Telfair8632/sr71-600/docs/cutting_templates_1to1.pdf

F02_Elevon_L | FOAM 3mm | QTY 1
Row 1/1 Col 1/1 | Origin (495.0,125.0) | Print at 100%; do not fit to page

Horizontal check 100 mm

Grid cross spacing 50 mm; adjacent pages overlap 10 mm; blue lines = score/locate, black lines = cut through.

F02_Elevon_R | FOAM 3mm | QTY 1
Row 1/1 Col 1/1 | Origin (495.0,-207.9) | Print at 100%; do not fit to page

F01_Wing_chine_NET | FOAM 3mm | QTY 1
Row 1/2 Col 1/4 | Origin (0.0,-210.0) | Print at 100%; do not fit to page

F01_Wing_chine_NET | FOAM 3mm | QTY 1
Row 1/2 Col 2/4 | Origin (180.0,-210.0) | Print at 100%; do not fit to page

F01_Wing_chine_NET | FOAM 3mm | QTY 1
Row 1/2 Col 3/4 | Origin (360.0,-210.0) | Print at 100%; do not fit to page

F01_Wing_chine_NET | FOAM 3mm | QTY 1
Row 1/2 Col 4/4 | Origin (540.0,-210.0) | Print at 100%; do not fit to page

F01_Wing_chine_NET | FOAM 3mm | QTY 1
Row 2/2 Col 1/4 | Origin (0.0,25.0) | Print at 100%; do not fit to page

F01_Wing_chine_NET | FOAM 3mm | QTY 1
Row 2/2 Col 2/4 | Origin (180.0,25.0) | Print at 100%; do not fit to page

F01_Wing_chine_NET | FOAM 3mm | QTY 1
Row 2/2 Col 3/4 | Origin (360.0,25.0) | Print at 100%; do not fit to page

F01_Wing_chine_NET | FOAM 3mm | QTY 1
Row 2/2 Col 4/4 | Origin (540.0,25.0) | Print at 100%; do not fit to page

F03_Fuselage_side | FOAM 3mm | QTY 2
Row 1/1 Col 1/3 | Origin (70.0,3.0) | Print at 100%; do not fit to page

F03_Fuselage_side | FOAM 3mm | QTY 2
Row 1/1 Col 2/3 | Origin (250.0,3.0) | Print at 100%; do not fit to page

F03_Fuselage_side | FOAM 3mm | QTY 2
Row 1/1 Col 3/3 | Origin (430.0,3.0) | Print at 100%; do not fit to page

F04_Roof_frame | FOAM 3mm | QTY 1
Row 1/1 Col 1/3 | Origin (70.0,-22.0) | Print at 100%; do not fit to page

F04_Roof_frame | FOAM 3mm | QTY 1
Row 1/1 Col 2/3 | Origin (250.0,-22.0) | Print at 100%; do not fit to page

F04_Roof_frame | FOAM 3mm | QTY 1
Row 1/1 Col 3/3 | Origin (430.0,-22.0) | Print at 100%; do not fit to page

F05_Battery_hatch | FOAM 3mm | QTY 1
Row 1/1 Col 1/2 | Origin (0.0,0.0) | Print at 100%; do not fit to page

F05_Battery_hatch | FOAM 3mm | QTY 1
Row 1/1 Col 2/2 | Origin (180.0,0.0) | Print at 100%; do not fit to page

F05_Avionics_hatch | FOAM 3mm | QTY 1
Row 1/1 Col 1/1 | Origin (0.0,0.0) | Print at 100%; do not fit to page

W01_Battery_tray | PLY 1mm | QTY 1
Row 1/1 Col 1/1 | Origin (95.0,-17.0) | Print at 100%; do not fit to page

W02_Bulkhead | PLY 1mm | QTY 3
Row 1/1 Col 1/1 | Origin (0.0,0.0) | Print at 100%; do not fit to page

F06_Nacelle_wrap | FOAM 2mm | QTY 2
Row 1/1 Col 1/2 | Origin (0.0,0.0) | Print at 100%; do not fit to page

F06_Nacelle_wrap | FOAM 2mm | QTY 2
Row 1/1 Col 2/2 | Origin (180.0,0.0) | Print at 100%; do not fit to page

F07_Vertical_fin | FOAM 3mm | QTY 2
Row 1/1 Col 1/1 | Origin (420.0,42.0) | Print at 100%; do not fit to page

F08_Belly_skid | FOAM 3mm | QTY 4
Row 1/1 Col 1/1 | Origin (510.0,-14.0) | Print at 100%; do not fit to page

F09_Spike_web | FOAM 2mm | QTY 2
Row 1/1 Col 1/1 | Origin (0.0,0.0) | Print at 100%; do not fit to page

W03_Motor_firewall | PLY 1mm | QTY 4
Row 1/1 Col 1/1 | Origin (-18.0,-18.0) | Print at 100%; do not fit to page

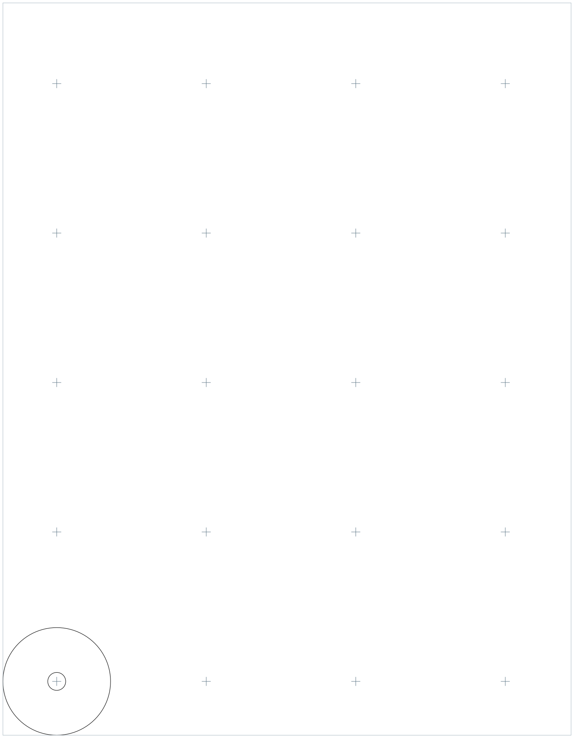
[picture p3: figure]

W04_Nacelle_former_BLANK | PLY 1mm | QTY 6
Row 1/1 Col 1/1 | Origin (-18.0,-18.0) | Print at 100%; do not fit to page

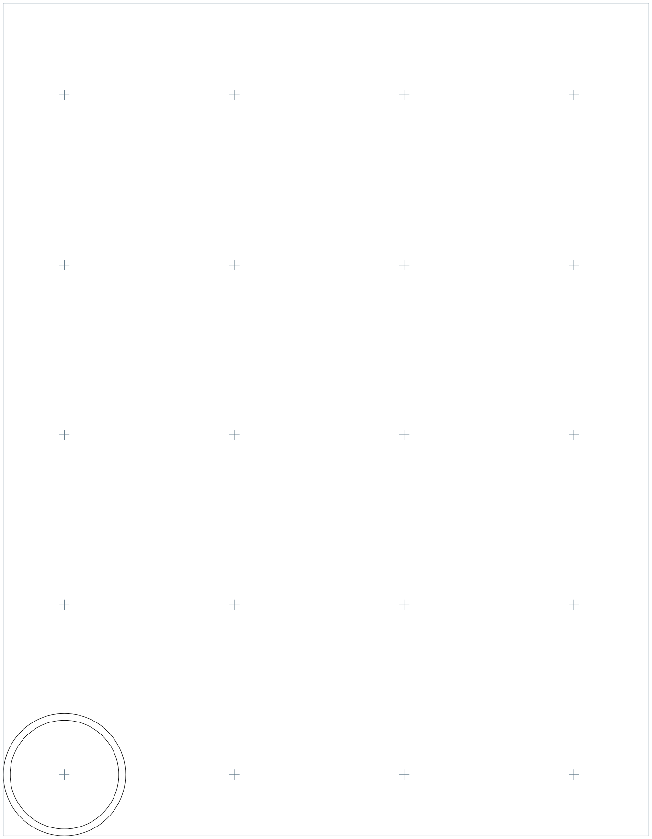
[picture p4: figure]
