Telfair8632/sr71-600/docs/cutaway.png

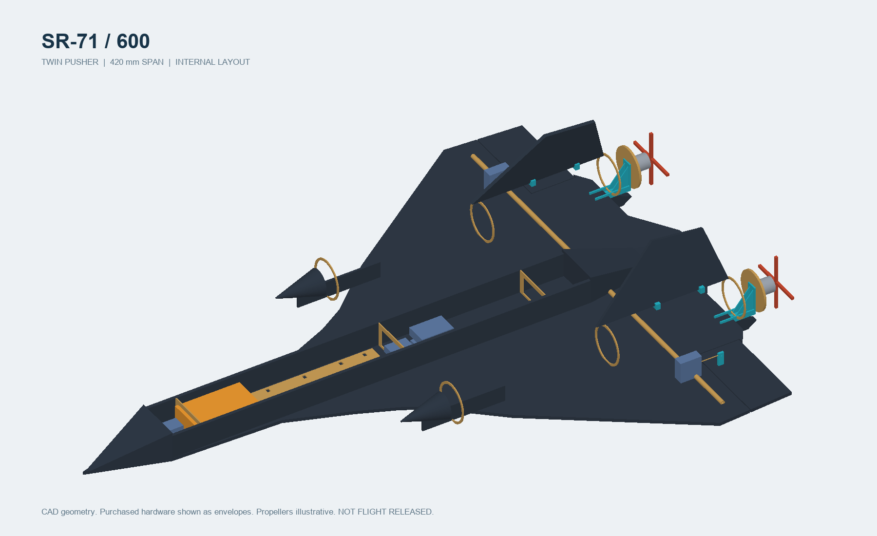
docs/cutaway.png
