Telfair8632/sr71-600/qa/pdf_render/circuit_design_E1_04.png

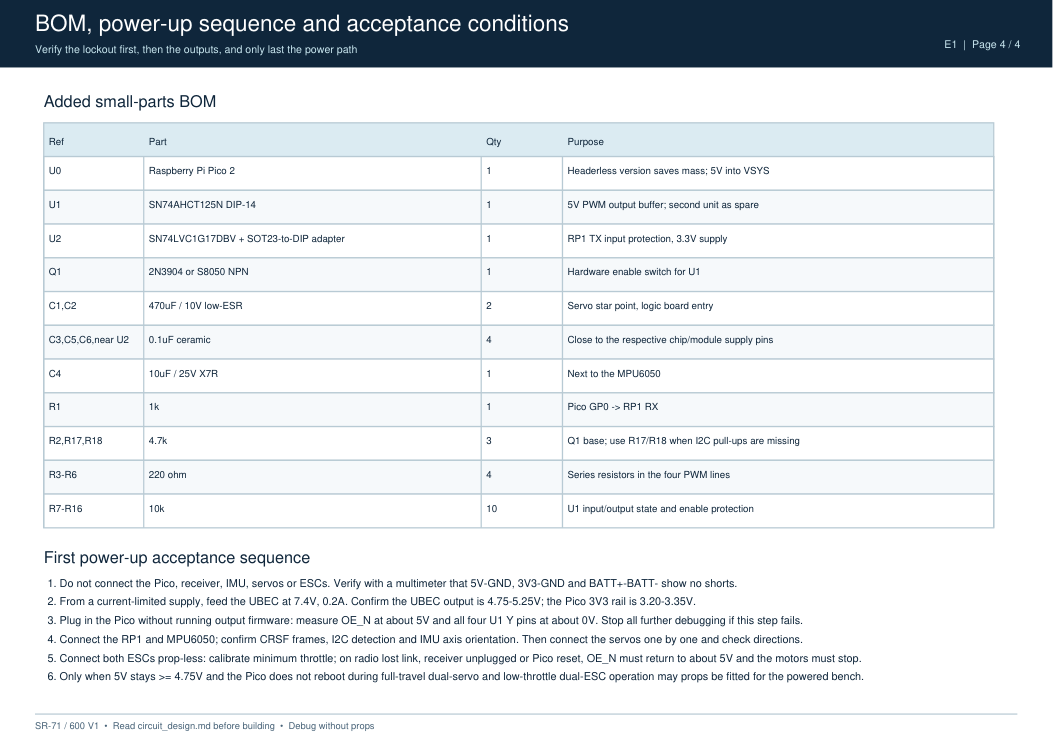
qa/pdf_render/circuit_design_E1_04.png
