Telfair8632/sr71-600/qa/pdf_render/engineering_report_09.png

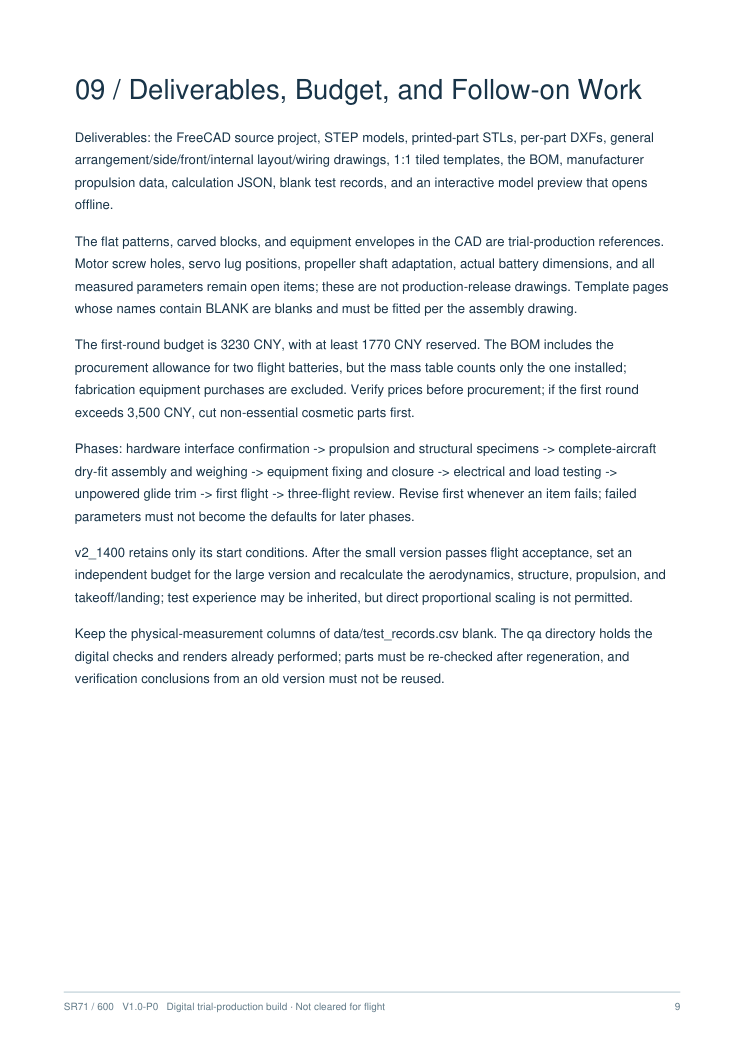
qa/pdf_render/engineering_report_09.png
