Telfair8632/sr71-600/qa/pdf_render/engineering_report_10.png

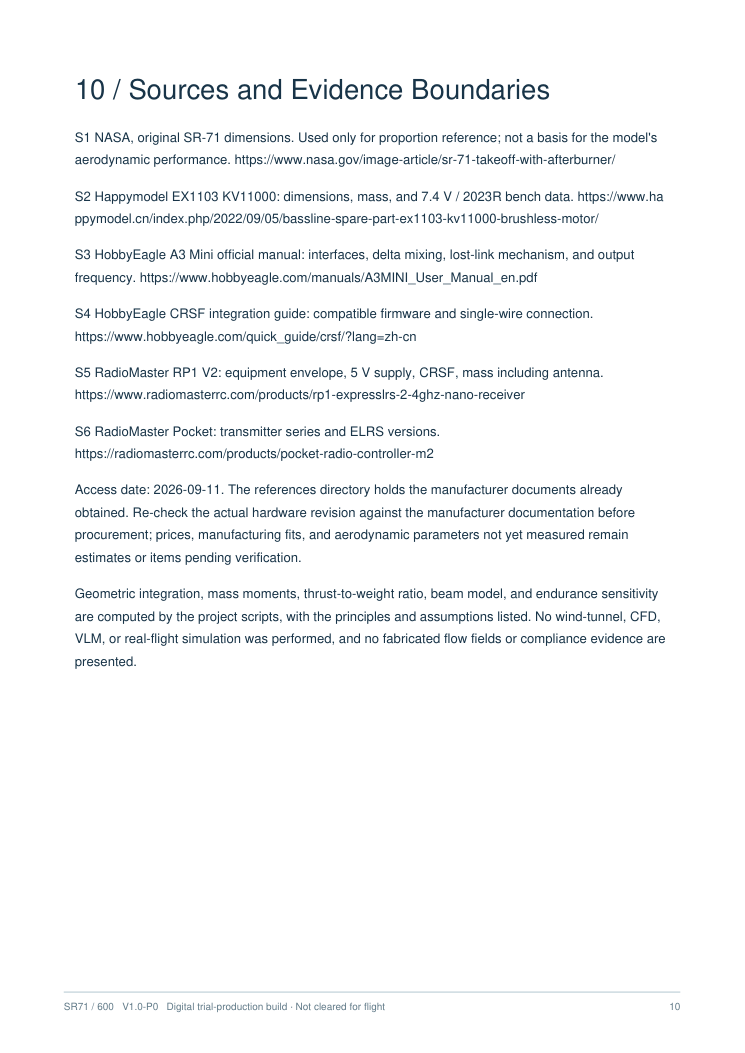
qa/pdf_render/engineering_report_10.png
