Telfair8632/sr71-600/qa/pdf_render/engineering_report_contact_1.png

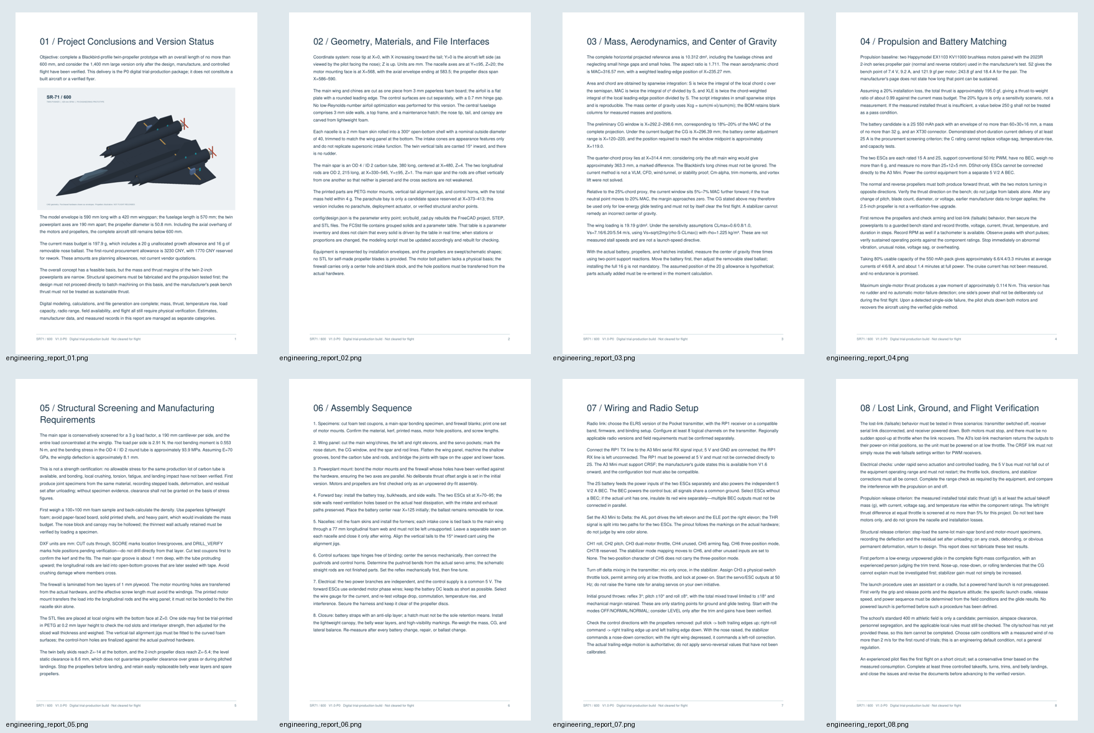
qa/pdf_render/engineering_report_contact_1.png
