Telfair8632/sr71-600/qa/viewer_overview.png

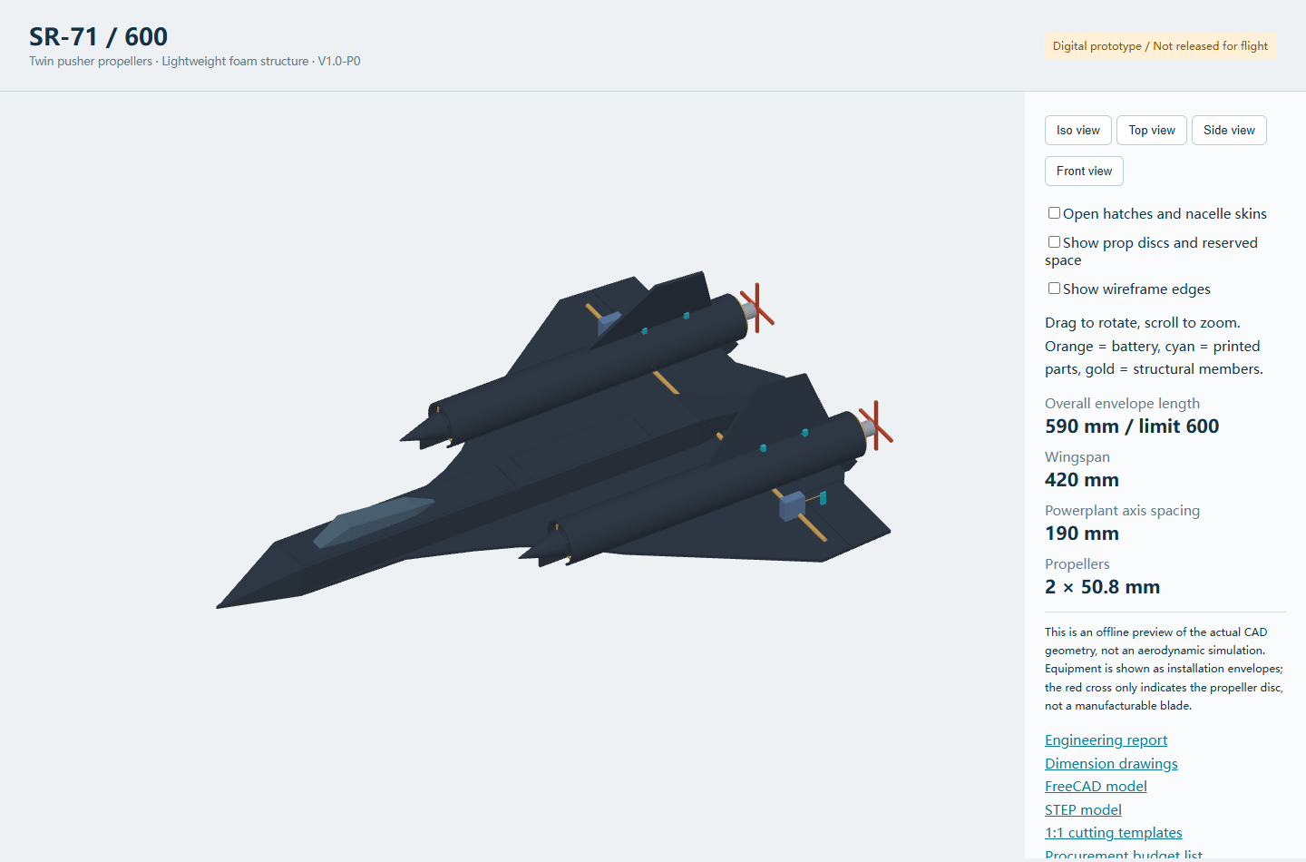
qa/viewer_overview.png
