Telfair8632/sr71-600/cad/SR71_600_P0.step

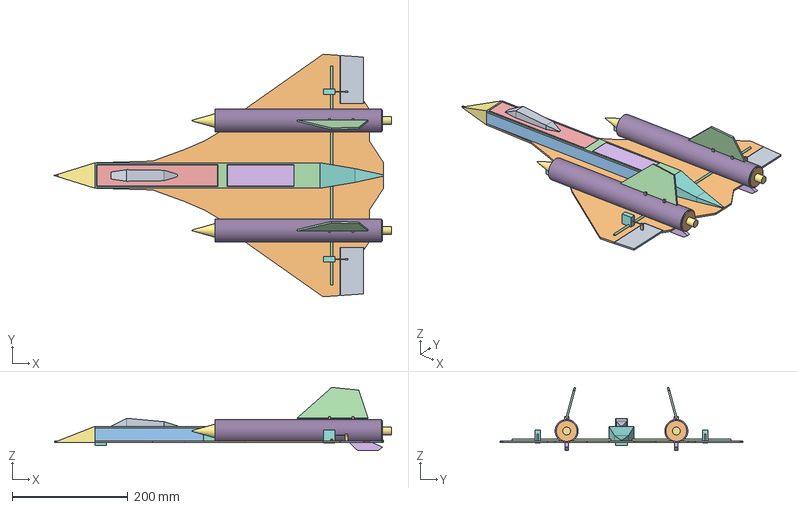
[picture p23: CAD file, 2026-10-15]
cad/SR71_600_P0.step
583.5 x 420.0 x 109.5 mm
左升降副翼（左后缘舵面）
右升降副翼（右后缘舵面）
主翼与边条整体板
中央机身左侧壁
中央机身右侧壁
中央机身顶框
前部电池舱盖
后部航电舱盖
机头泡沫整形块
机尾泡沫整形块
座舱泡沫外形件
电池托板
前隔框（X=98）
中隔框（X=287）
后隔框（X=419）
横向碳管主梁
左机舱纵向碳杆
左发动机舱泡沫外壳
左进气锥外形件
左进气锥支撑腹板
左机舱前成形圈（X=285）
左机舱中成形圈（X=430）
左机舱后成形圈（X=548）
左电机防火墙毛坯
左电机托
左垂尾
左垂尾前托（X=474）
左垂尾后托（X=515）
左机腹耐磨滑橇
左无刷电机安装包络
左升降副翼舵机安装包络
左升降副翼拉杆
左升降副翼舵角
右机舱纵向碳杆
右发动机舱泡沫外壳
右进气锥外形件
右进气锥支撑腹板
右机舱前成形圈（X=285）
右机舱中成形圈（X=430）
右机舱后成形圈（X=548）
右电机防火墙毛坯
右电机托
右垂尾
右垂尾前托（X=474）
右垂尾后托（X=515）
右机腹耐磨滑橇
右无刷电机安装包络
右升降副翼舵机安装包络
右升降副翼拉杆
右升降副翼舵角
2S电池安装包络
左电调安装包络
右电调安装包络
独立BEC安装包络
ELRS接收机安装包络
三角翼稳定器安装包络
可拆机头配重安装包络
