Telfair8632/sr71-600/cut/F06_Nacelle_wrap.dxf

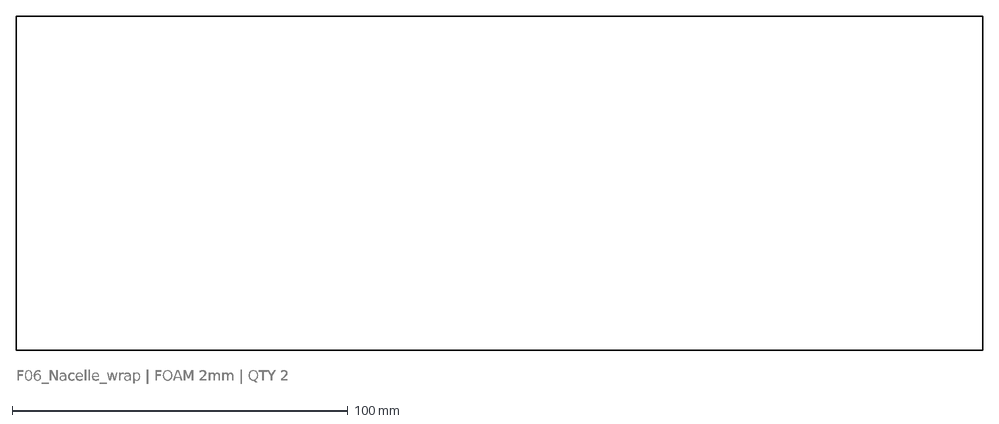
[picture p24: CAD file, 2026-10-15]
cut/F06_Nacelle_wrap.dxf
F06_Nacelle_wrap | FOAM 2mm | QTY 2
