Telfair8632/sr71-600/print/Fin_saddle_L_474.stl

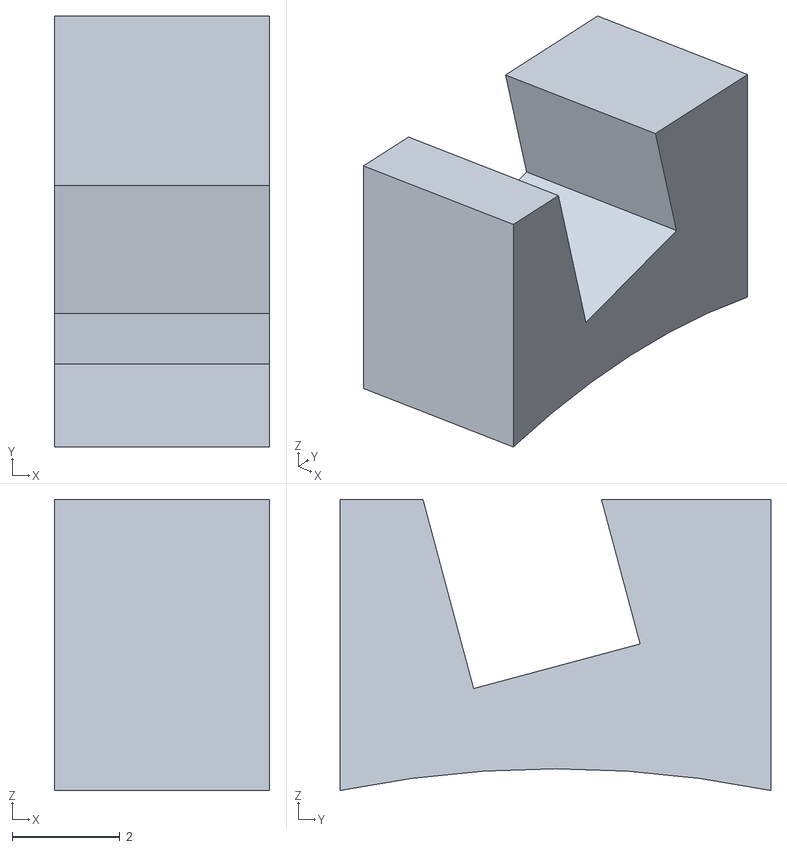
[picture p25: CAD file, 2026-10-15]
print/Fin_saddle_L_474.stl
4.00 x 8.00 x 5.40
