Telfair8632/sr71-600/cut/F01_Wing_chine_NET.dxf

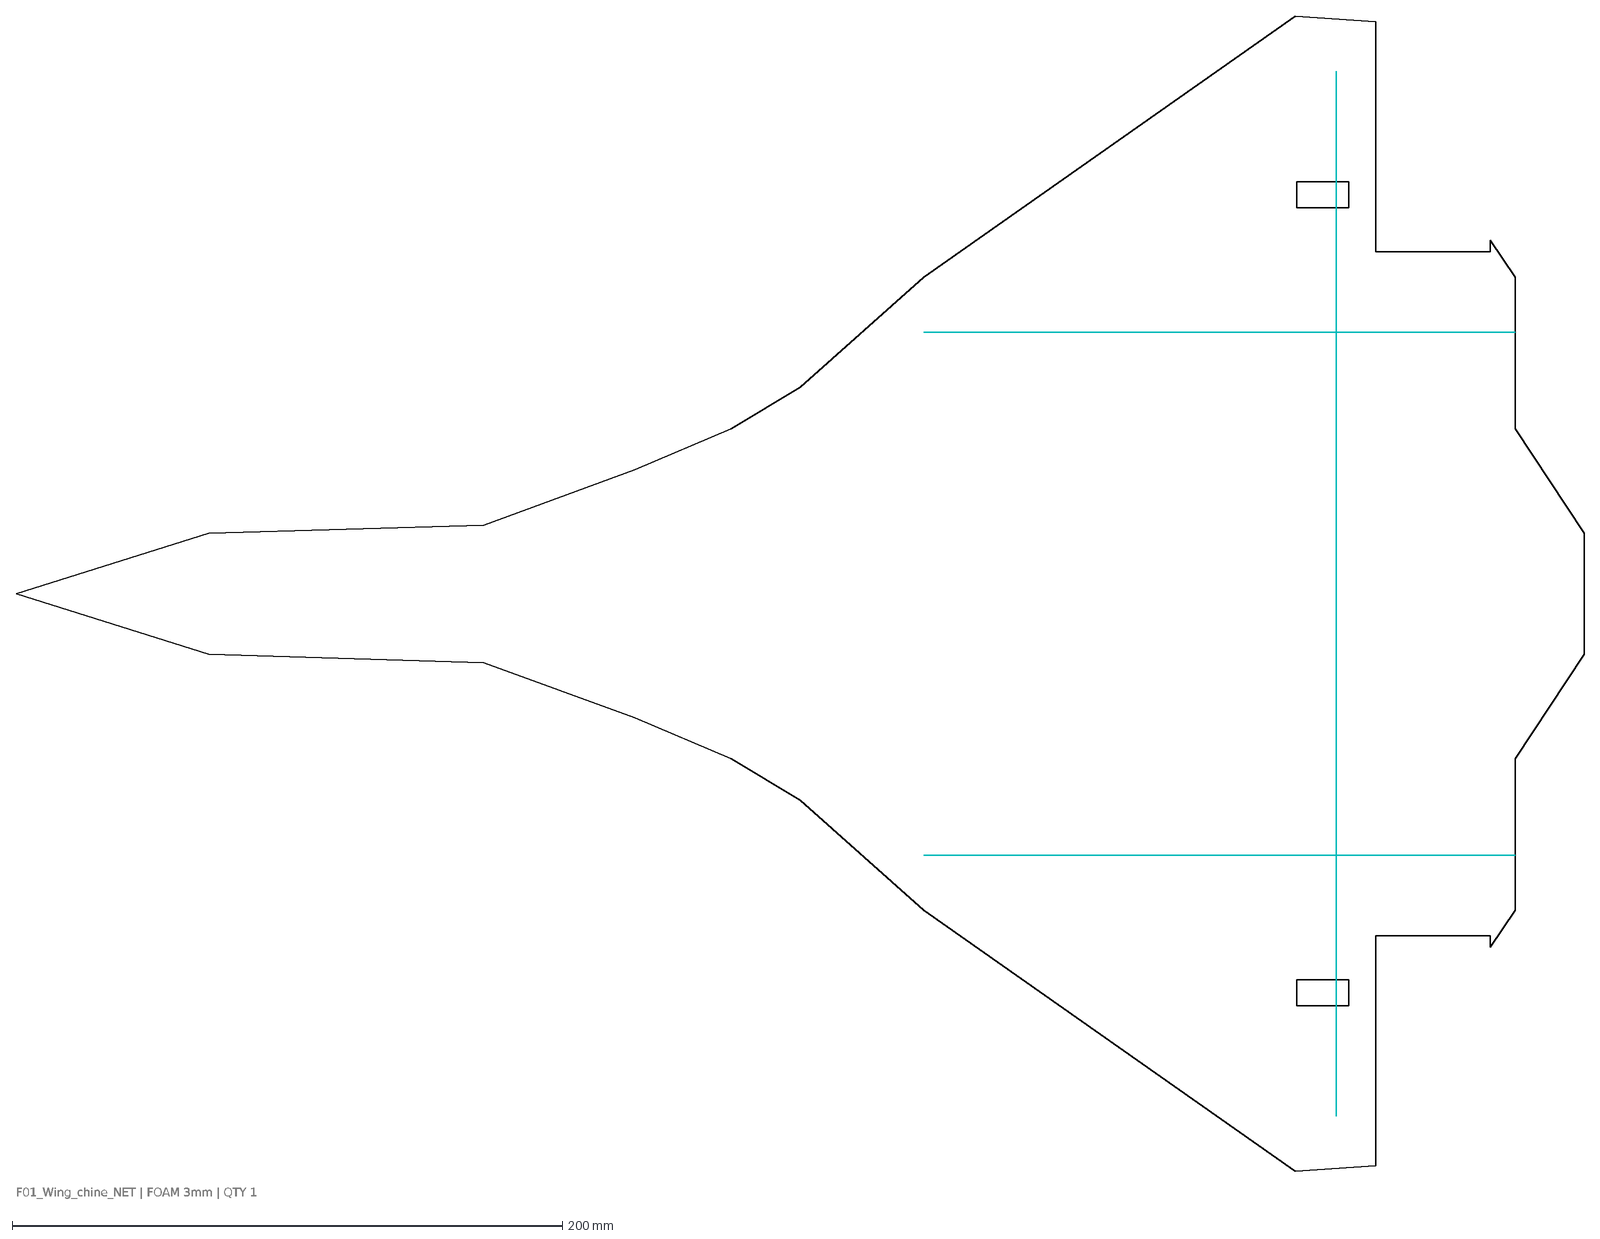
[picture p26: CAD file, 2026-10-15]
cut/F01_Wing_chine_NET.dxf
F01_Wing_chine_NET | FOAM 3mm | QTY 1
