Telfair8632/sr71-600/cut/F02_Elevon_R.dxf

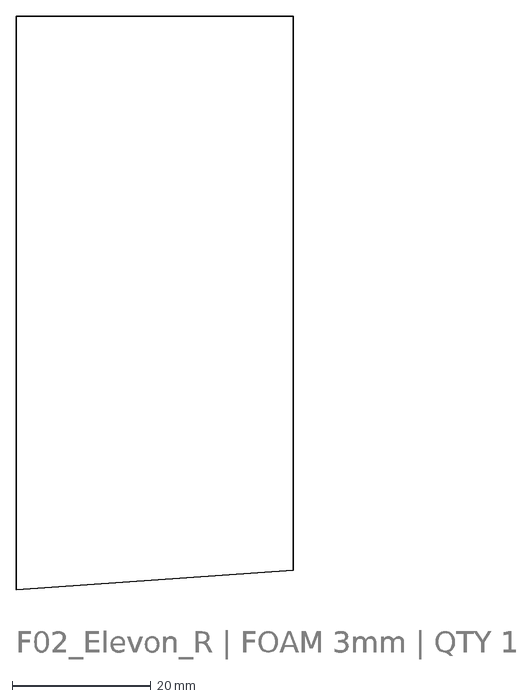
[picture p27: CAD file, 2026-10-15]
cut/F02_Elevon_R.dxf
F02_Elevon_R | FOAM 3mm | QTY 1
