Telfair8632/sr71-600/print/Control_horn_R.stl

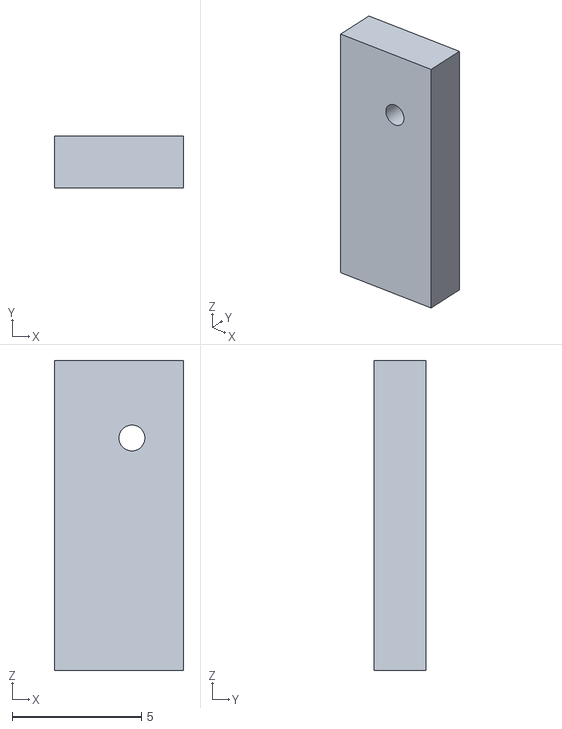
[picture p28: CAD file, 2026-10-15]
print/Control_horn_R.stl
5.00 x 2.00 x 12.0
