Telfair8632/sr71-600/cut/F05_Battery_hatch.dxf

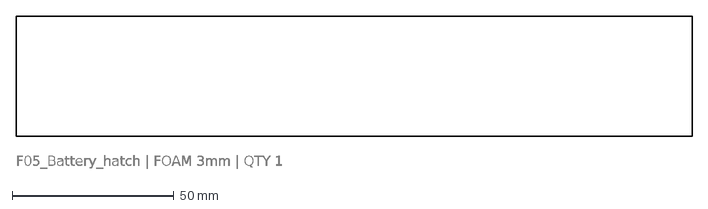
[picture p29: CAD file, 2026-10-15]
cut/F05_Battery_hatch.dxf
F05_Battery_hatch | FOAM 3mm | QTY 1
