Telfair8632/sr71-600/cut/F03_Fuselage_side.dxf

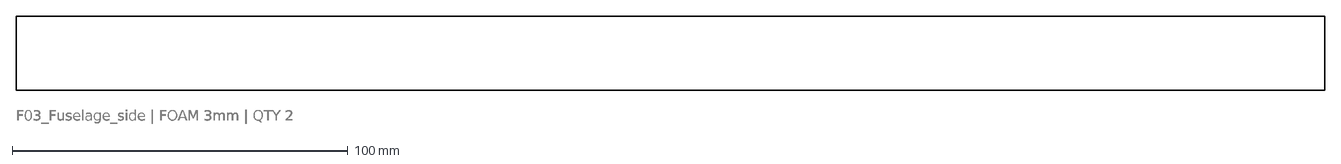
[picture p30: CAD file, 2026-10-15]
cut/F03_Fuselage_side.dxf
F03_Fuselage_side | FOAM 3mm | QTY 2
