Telfair8632/sr71-600/print/Motor_saddle_L.stl

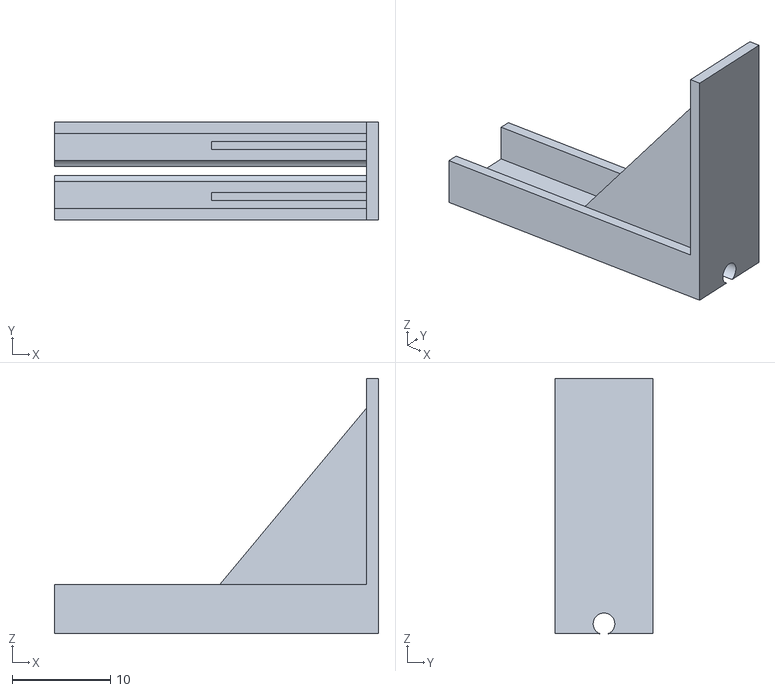
[picture p31: CAD file, 2026-10-15]
print/Motor_saddle_L.stl
33.0 x 10.0 x 26.0
