Telfair8632/sr71-600/cut/F08_Belly_skid.dxf

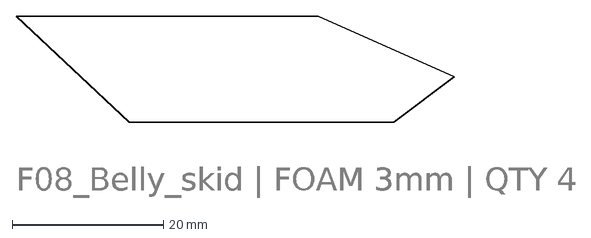
[picture p32: CAD file, 2026-10-15]
cut/F08_Belly_skid.dxf
F08_Belly_skid | FOAM 3mm | QTY 4
