Telfair8632/sr71-600/cut/F02_Elevon_L.dxf

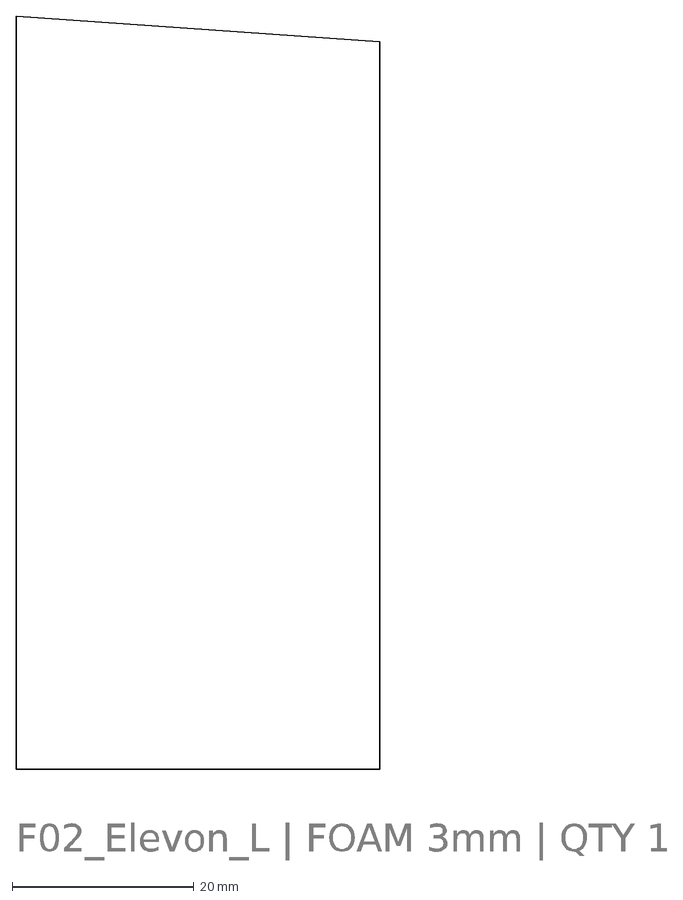
[picture p33: CAD file, 2026-10-15]
cut/F02_Elevon_L.dxf
F02_Elevon_L | FOAM 3mm | QTY 1
