Telfair8632/sr71-600/cut/F07_Vertical_fin.dxf

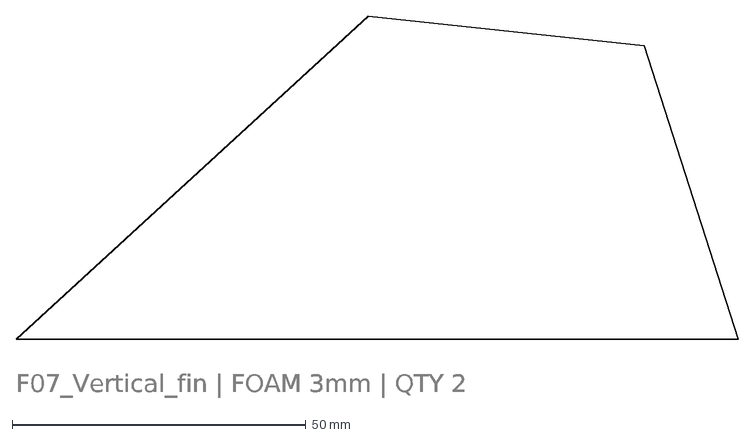
[picture p34: CAD file, 2026-10-15]
cut/F07_Vertical_fin.dxf
F07_Vertical_fin | FOAM 3mm | QTY 2
