Telfair8632/sr71-600/cut/W04_Nacelle_former_BLANK.dxf

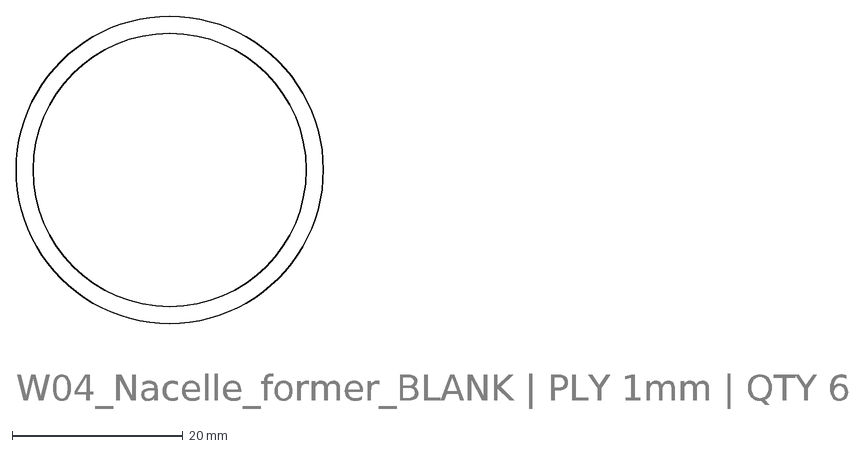
[picture p35: CAD file, 2026-10-15]
cut/W04_Nacelle_former_BLANK.dxf
W04_Nacelle_former_BLANK | PLY 1mm | QTY 6
