Telfair8632/sr71-600/cut/W02_Bulkhead.dxf

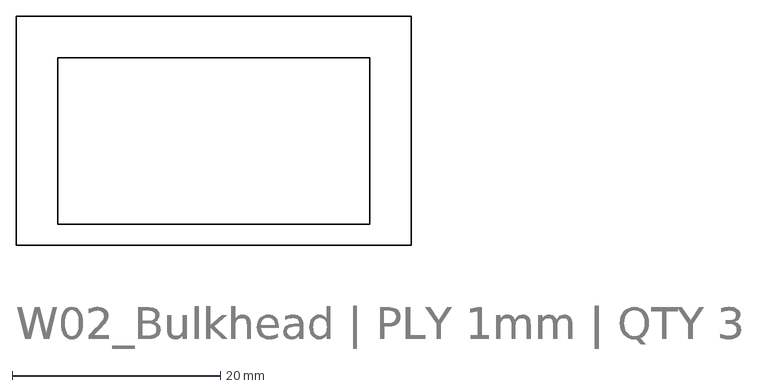
[picture p36: CAD file, 2026-10-15]
cut/W02_Bulkhead.dxf
W02_Bulkhead | PLY 1mm | QTY 3
