Telfair8632/sr71-600/cut/W03_Motor_firewall.dxf

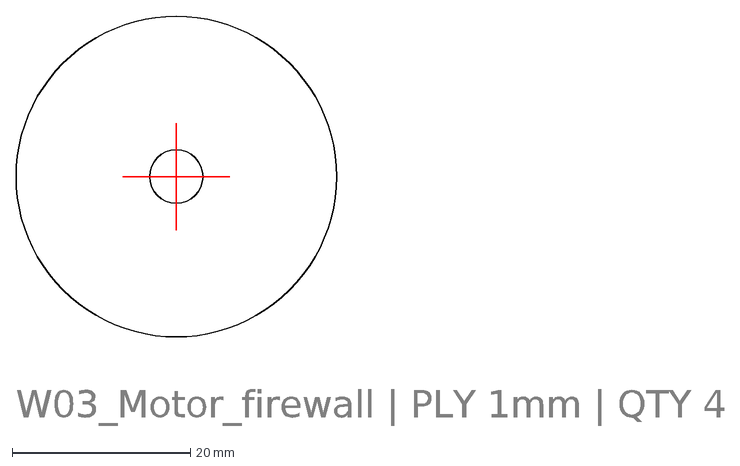
[picture p37: CAD file, 2026-10-15]
cut/W03_Motor_firewall.dxf
W03_Motor_firewall | PLY 1mm | QTY 4
