Telfair8632/sr71-600/cut/F05_Avionics_hatch.dxf

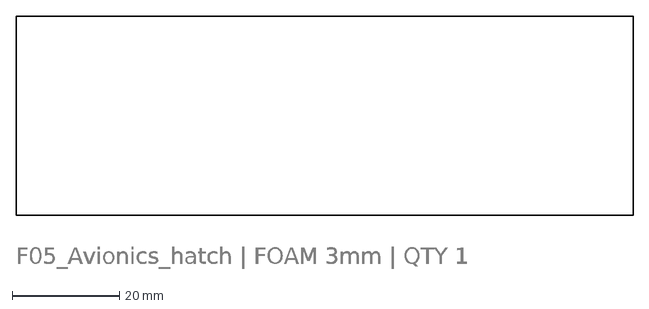
[picture p38: CAD file, 2026-10-15]
cut/F05_Avionics_hatch.dxf
F05_Avionics_hatch | FOAM 3mm | QTY 1
