Telfair8632/sr71-600/cut/W01_Battery_tray.dxf

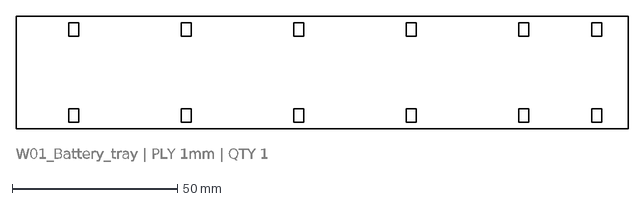
[picture p39: CAD file, 2026-10-15]
cut/W01_Battery_tray.dxf
W01_Battery_tray | PLY 1mm | QTY 1
