Telfair8632/sr71-600/cut/F04_Roof_frame.dxf

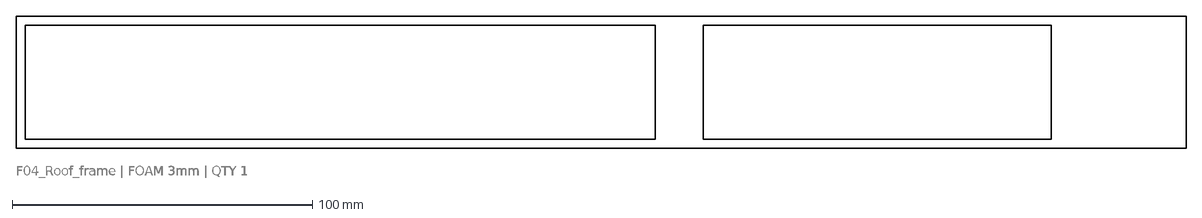
[picture p40: CAD file, 2026-10-15]
cut/F04_Roof_frame.dxf
F04_Roof_frame | FOAM 3mm | QTY 1
