Telfair8632/sr71-600/cut/F09_Spike_web.dxf

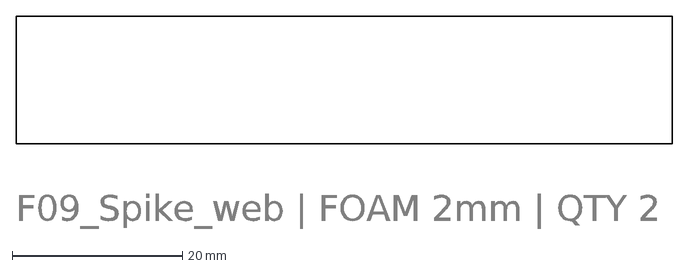
[picture p41: CAD file, 2026-10-15]
cut/F09_Spike_web.dxf
F09_Spike_web | FOAM 2mm | QTY 2
