Telfair8632/sr71-600/(list of files, cad)

Other CAD files:
print/Fin_saddle_R_515.stl
print/Fin_saddle_R_474.stl
cad/SR71_600_P0.FCStd
