Telfair8632/sr71-600/docs/assembly_dimensions.pdf

# 01 / General Arrangement, Top View and Assembly Datums

Scale 1:2; X from nose to tail; +Y is the aircraft left side. Teal lines: structural members; orange lines: preliminary CG window.

V1.0-P0 | Units: mm | Digital trial-production build: hole positions and flight parameters not measured or released

Overall envelope 590 / limit 600

Fuselage 570

Axis spacing 190 Wingspan 420

Preliminary CG X=292.2-298.6; first-order estimate from the full chine projection, to be confirmed by glide testing.

Nacelle OD 40; motor axis Z=20; propeller diameter 50.8; elevon hinge at X=495, gap 0.7.

# 02 / Side View, Front View, and Height

Side/front views at 1:2. Equipment shown as assembly envelopes only; motor hole positions and screw lengths to be verified against hardware.

590

Height envelope approx. 110

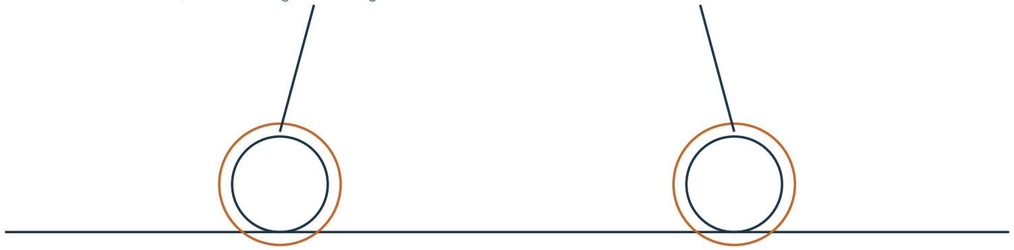
[picture p42: figure]

420

190

Main spar center Z=4, longitudinal rods center Z=1; vertically offset—do not drill through the carbon tubes.

Skid bottom Z=-14; propeller disc bottom Z=-5.4; level static clearance 8.6.

Vertical tails canted 15° inward. No rudder in the initial version; continued flight on a single motor is not verified.

# 03 / Internal Layout and Part Classification

Teal: printed parts; gold: plywood/carbon rods; orange: battery. Rendered from CAD geometry; no scale indicated.

Forward ESCs X=70–95

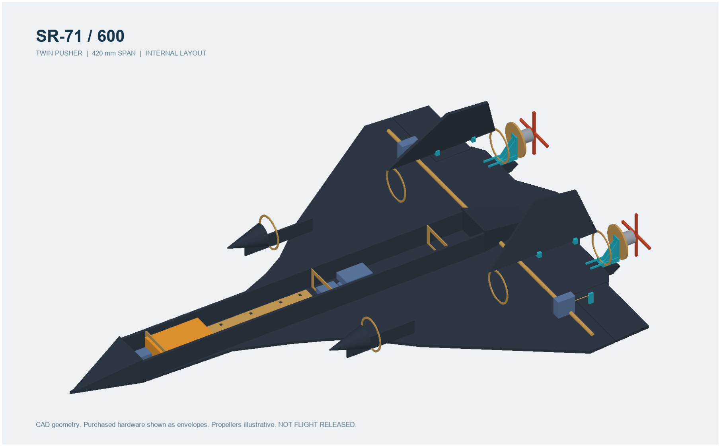
[picture p43: figure]

Battery center X=120–220

BEC center X=295

Receiver center X=315

Stabilizer center X=325

Empty parachute bay X=373–413

Motor mounts X=566–568

Removable ballast X~80

Weigh and measure CG before closing

# 04 / Electrical Block Diagram and Signal Interfaces

Functional block diagram; does not represent actual connector pin orders. Control supply 5 V throughout; propulsion 2S.

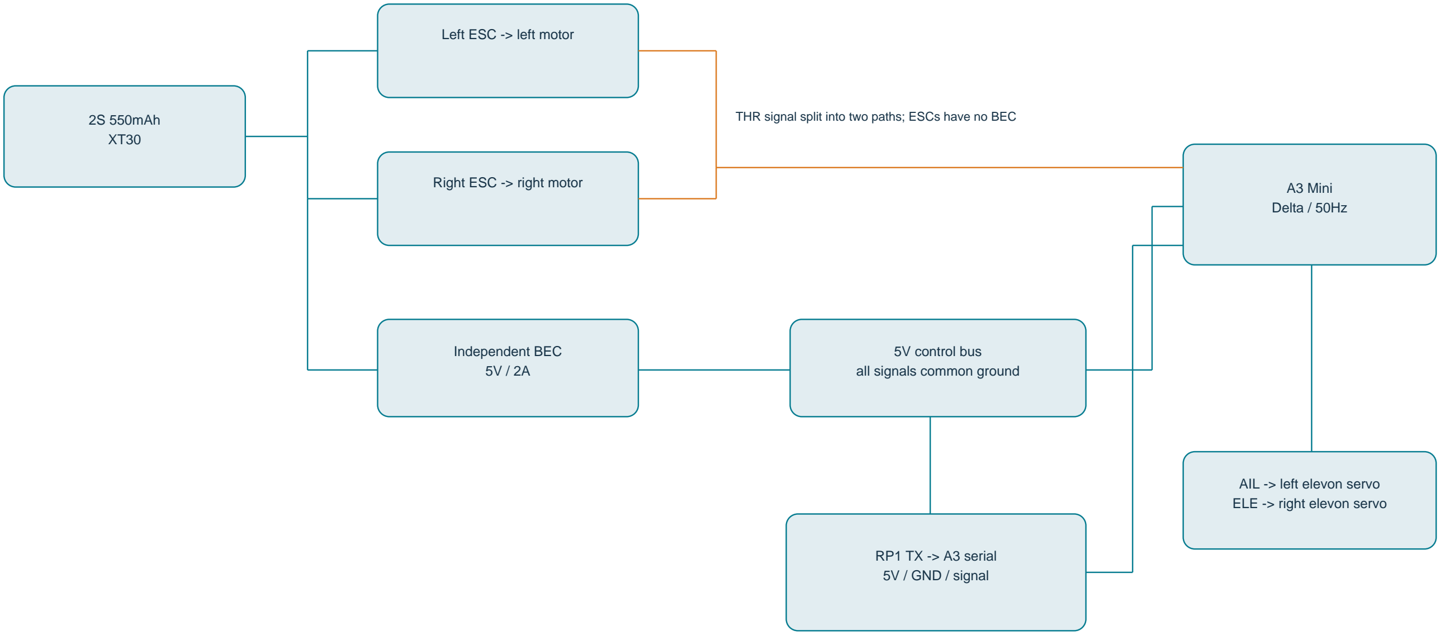
[picture p44: figure]
2S 550mAh XT30; Left ESC -> left motor; Right ESC -> right motor; Independent BEC 5V / 2A; 5V control bus all signals common ground; RP1 TX -> A3 serial 5V / GND / signal; A3 Mini Delta / 50Hz; AIL -> left elevon servo ELE -> right elevon servo

THR signal split into two paths; ESCs have no BEC

CH1 roll, CH2 pitch, CH3 dual-motor throttle, CH5 arm flag, CH6 mode; CH4/7/8 reserved.

Disable delta mixing in the transmitter; the A3 Mini mixes once; the RP1 must be powered at 5 V.

With propellers removed, check all three lost-link cases: transmitter off, serial disconnected, receiver unpowered; both motors must stop.

Select CRSF-compatible firmware on the A3; the mode channel moves to CH6. Verify every pin against the hardware markings.
