Telfair8632/sr71-600/qa/pdf_render/assembly_instructions_01.png

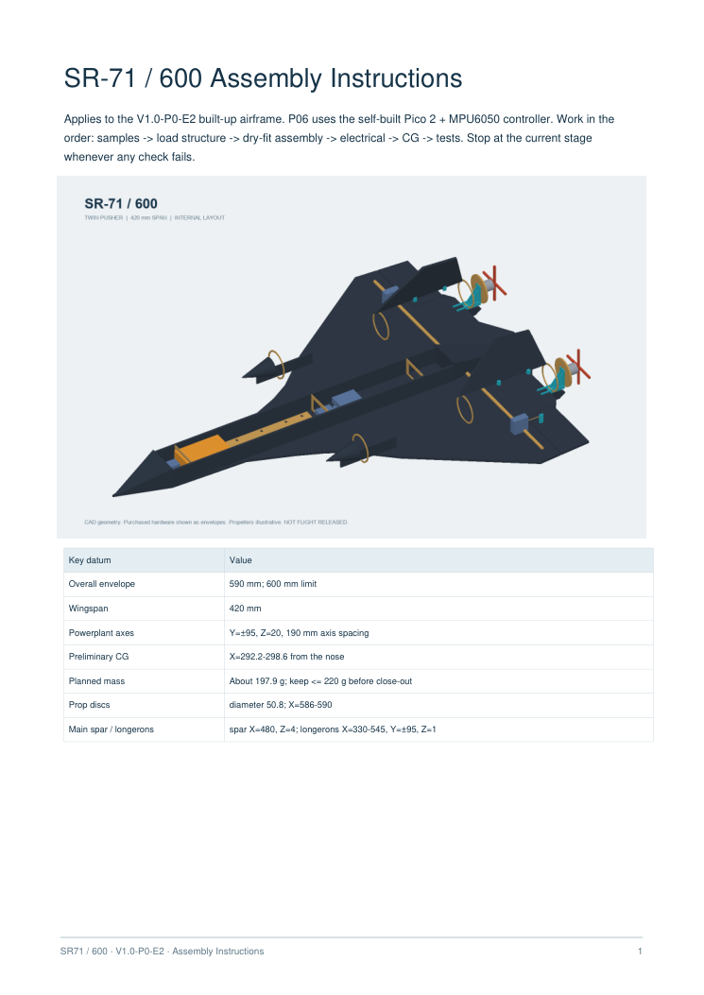
qa/pdf_render/assembly_instructions_01.png
