Telfair8632/sr71-600/qa/reference_wiring.png

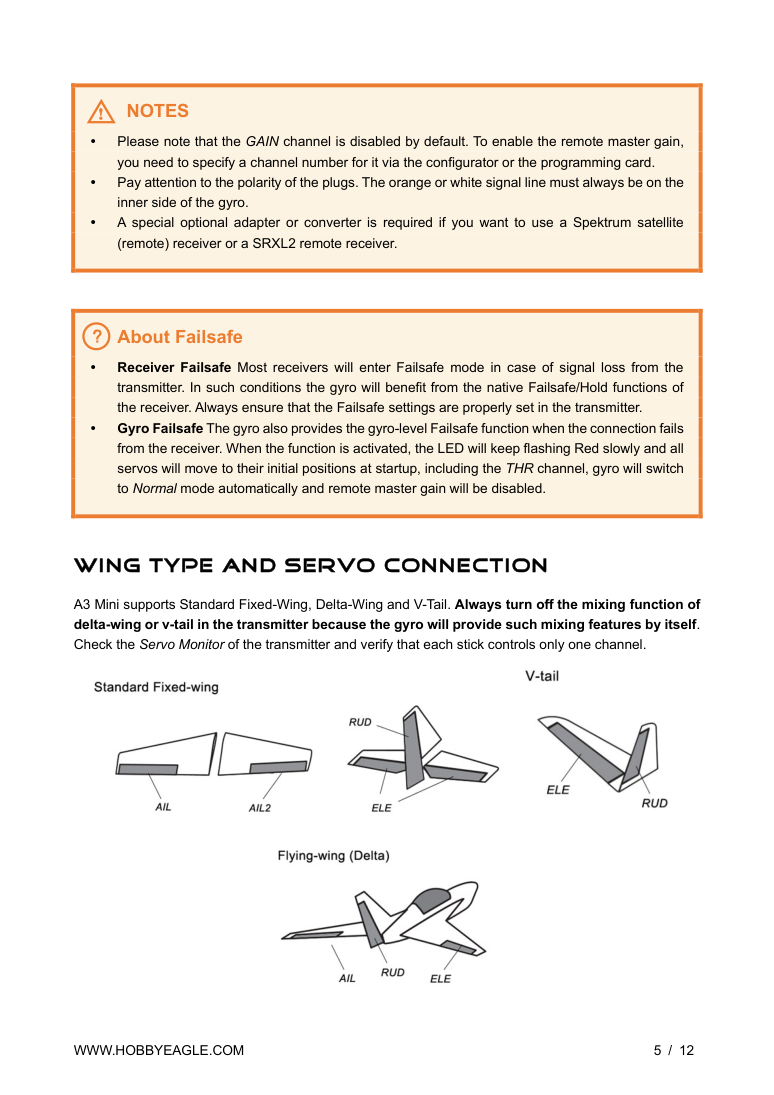
qa/reference_wiring.png
