Telfair8632/sr71-600/data/test_records.csv

id | test | status | date | operator | configuration | measurement | result | issue
MASS | All-up mass and CG | NOT TESTED
FIT | Hole positions and as-received device dimensions | NOT TESTED
SHORT | Power-off short-circuit/polarity check | NOT TESTED
BEC0 | BEC no-load and current-limited power-up | NOT TESTED
PICO0 | Pico stability pre-verification (level 3) | PASS | 2026-10-07 | ZCode+user | Pico 2 USB-powered, sr71fc_level3 firmware (with 8 s serial-attach wait), no peripheral wiring | 30 min soak, 1808 lines, missed=0, no unexpected resets, maxloop≤153us; reset within ≤2s of sending w, reset cause: WATCHDOG; after reset DISARMED/oe_gate=OFF/all_outputs=LOW; log firmware/scripts/soak_level3_20261007_232459.log | Pass | None
IMU0 | MPU6050 communication/axis orientation/bias/sampling rate | PASS | 2026-10-13 | ZCode+user | FMYSE PH2.0 module Dupont-wired directly to Pico 2: V→3V3 G→GND SDA→GP4 SCL→GP5 INT→GP3, level4 firmware (i2c1→i2c0 fix + detection retry) | WHO_AM_I=0x68 PASS; 2000-sample calibration, bias gx=-66/gy=24/gz=-10 LSB; 10 min=120116 samples rate=200.2Hz gap15=0 fifo=0 maxgap=4998us (cold start); axis-orientation check: all three axes respond in consistent directions; CSV=firmware/scripts/imu_10min.csv | Pass (with 1 known issue) | Accelerometer scale reads low: static |a|=0.79~0.87g (expected 1.0g), a uniform deviation of about -20%; caused by a clone chip or the earlier reverse-power incident; attitude uses ratios so it is unaffected; before installation apply a 1/0.80 scale correction in firmware or replace with a genuine GY-521
RX0 | RP1 binding/channels/failsafe flags | NOT TESTED
PWM0 | Four-channel PWM waveforms and buffer safe states | NOT TESTED
SERVO | Servo direction/travel/bus load | NOT TESTED
MOTOR_L | Left powertrain single-engine test | NOT TESTED
MOTOR_R | Right powertrain single-engine test | NOT TESTED
MOTOR_PAIR | Twin-engine matching and installed thrust | NOT TESTED
VIB | IMU and radio link under powertrain vibration | NOT TESTED
THRUST | Thrust/current/voltage/temperature/duration | NOT TESTED
POWER | BEC bus load and restart | NOT TESTED
FAIL1 | Transmitter switched off | NOT TESTED
FAIL2 | Receiver serial disconnect | NOT TESTED
FAIL3 | Receiver power loss | NOT TESTED
FAIL4 | MPU6050 disconnect/data timeout | NOT TESTED
FAIL5 | Pico reset and watchdog recovery | NOT TESTED
STRUCT | Load/deflection/permanent set | NOT TESTED
RANGE | Range/interference | NOT TESTED
GLIDE | Unpowered trim | NOT TESTED
FLIGHT1 | First flight | NOT TESTED
FLIGHT2 | Second flight | NOT TESTED
FLIGHT3 | Third flight | NOT TESTED
