Telfair8632/sr71-600/qa/pdf_render/cutting_templates_1to1_04.png

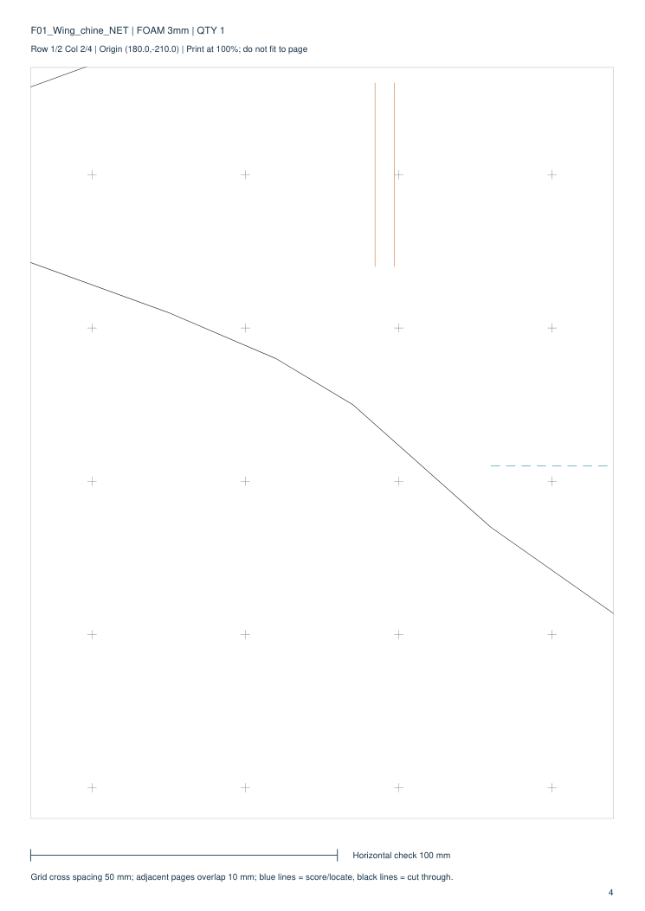
qa/pdf_render/cutting_templates_1to1_04.png
