Telfair8632/sr71-600/qa/pdf_render/cutting_templates_1to1_contact_1.png

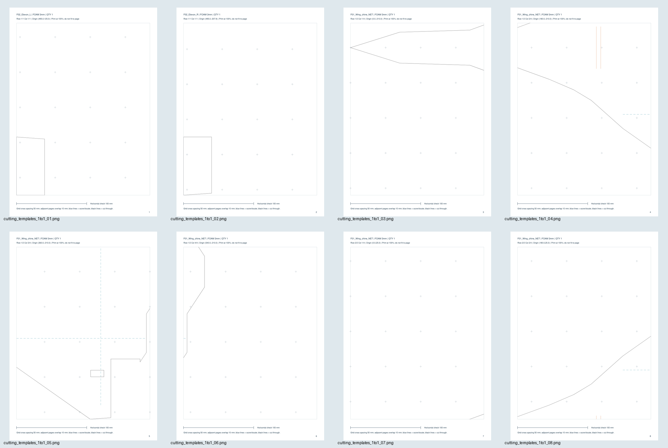
qa/pdf_render/cutting_templates_1to1_contact_1.png
