Telfair8632/sr71-600/qa/pdf_render/procurement_list_01.png

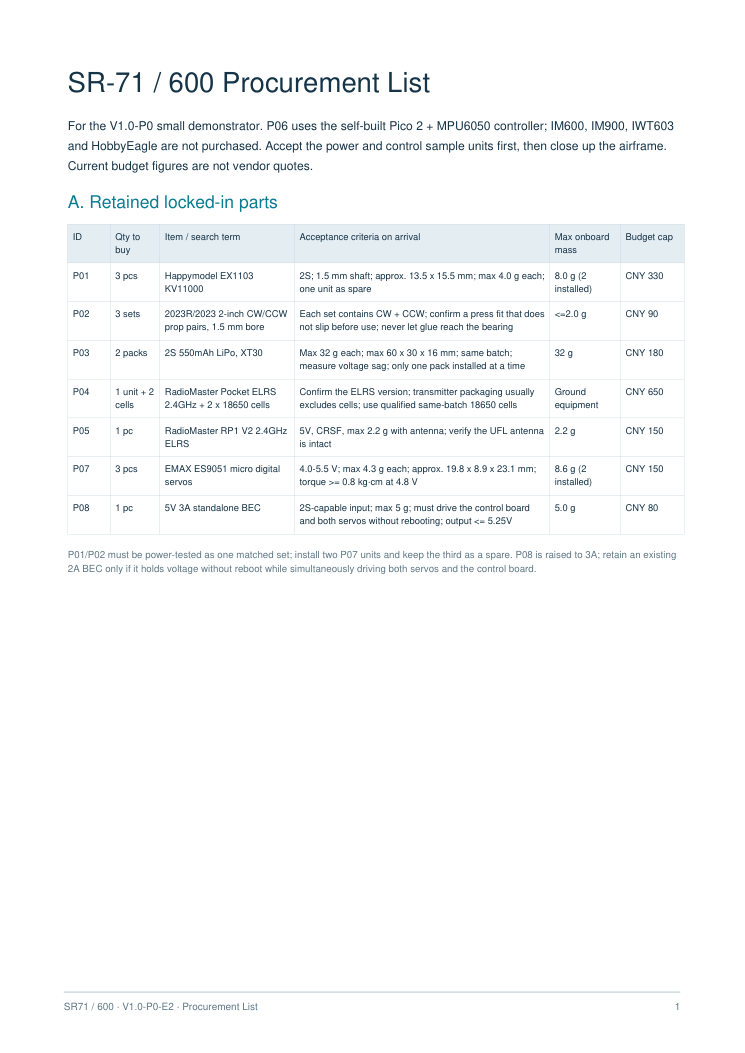
qa/pdf_render/procurement_list_01.png
