Telfair8632/sr71-600/qa/pdf_render/procurement_list_04.png

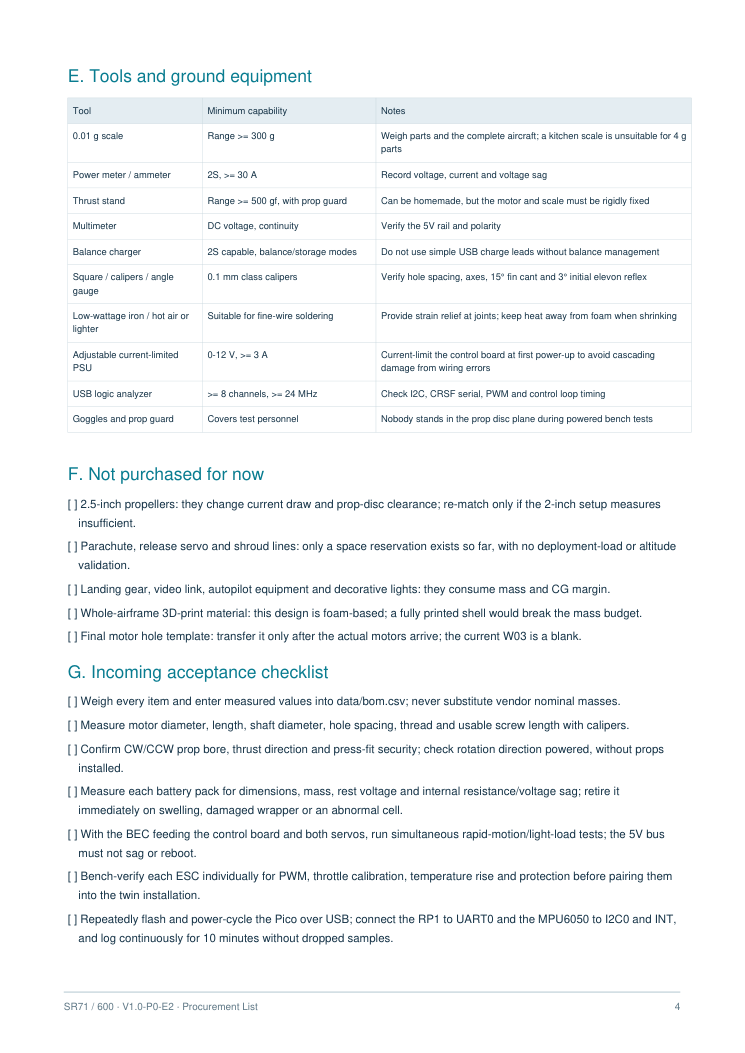
qa/pdf_render/procurement_list_04.png
