Telfair8632/sr71-600/qa/pdf_render/procurement_list_contact_1.png

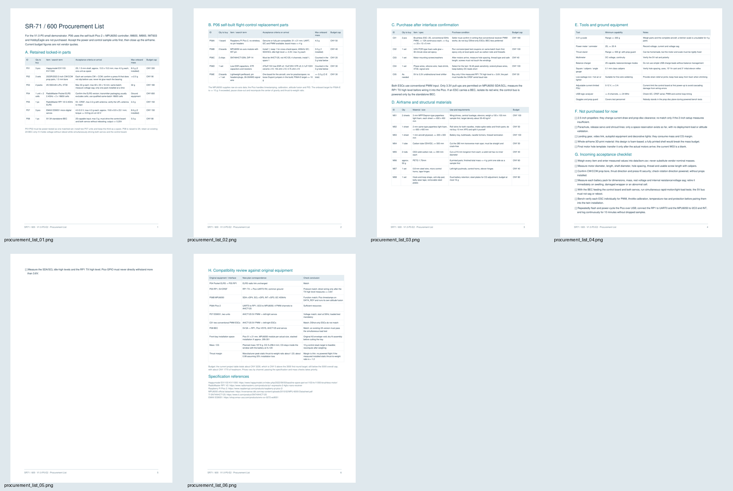
qa/pdf_render/procurement_list_contact_1.png
